CMPE-310/Lab4/Schematics/8086_Trainer_System/8086.JPG

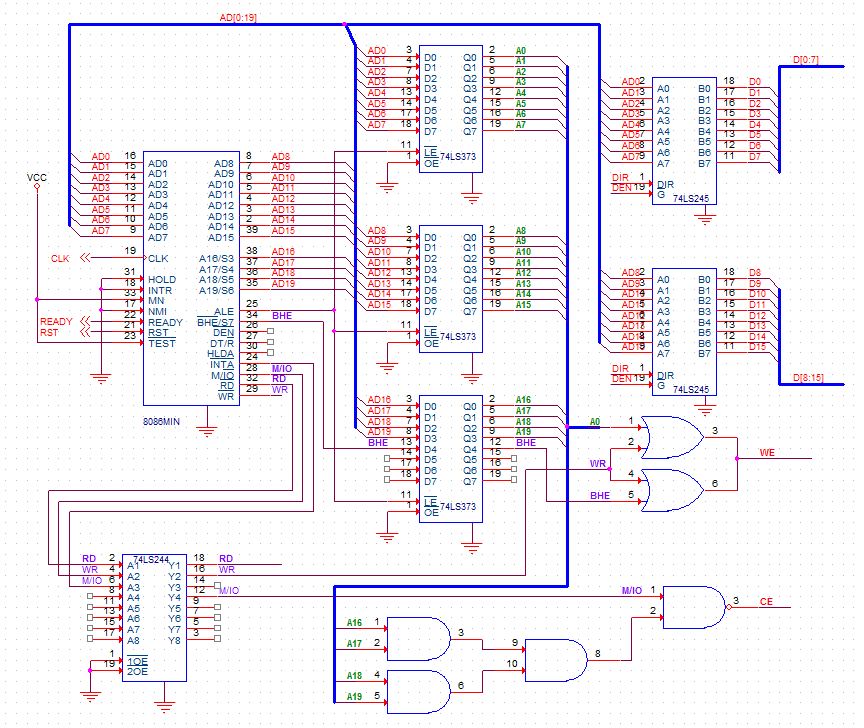
Schematics/8086_Trainer_System/8086.JPG
