CMPE-310/Lab4/Schematics/8086_Trainer_System/CY7C128A_SRAM_v2.JPG

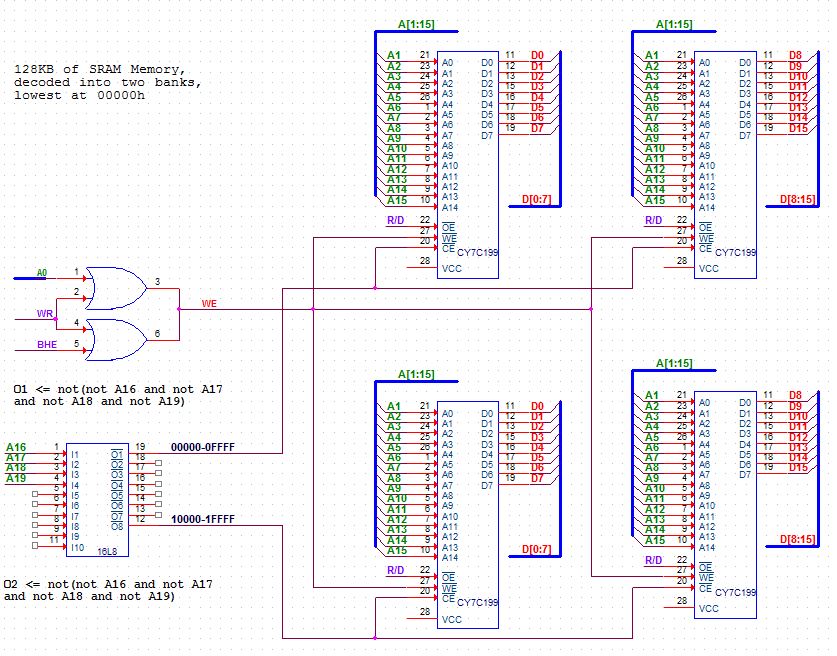
Schematics/8086_Trainer_System/CY7C128A_SRAM_v2.JPG
