CMPE-310/Lab4/Meeting #1 Notes.jpg

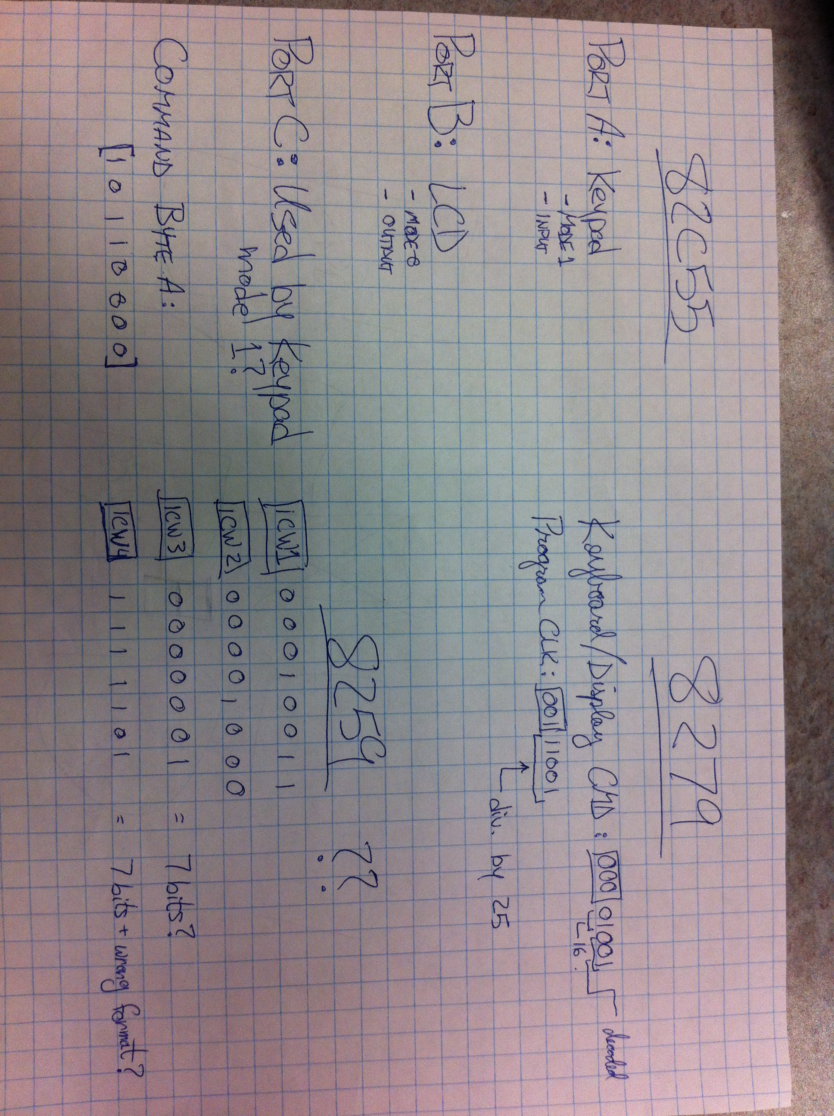
Meeting #1 Notes.jpg
