CMPE-310/Lab4/Program_8279_Microprocessor Techniques  By D.A.Godse A.P.Godse.tiff

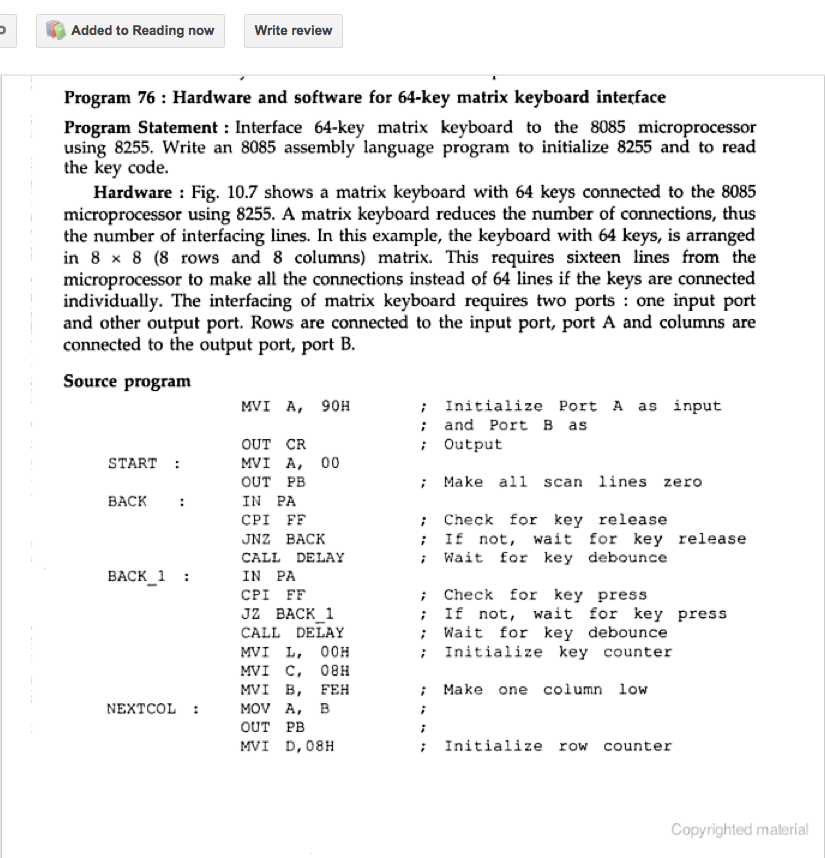
Program_8279_Microprocessor Techniques By D.A.Godse A.P.Godse.tiff
