CMPE-310/Lab4/Schematics/8086_Trainer_System/7 segement.PNG

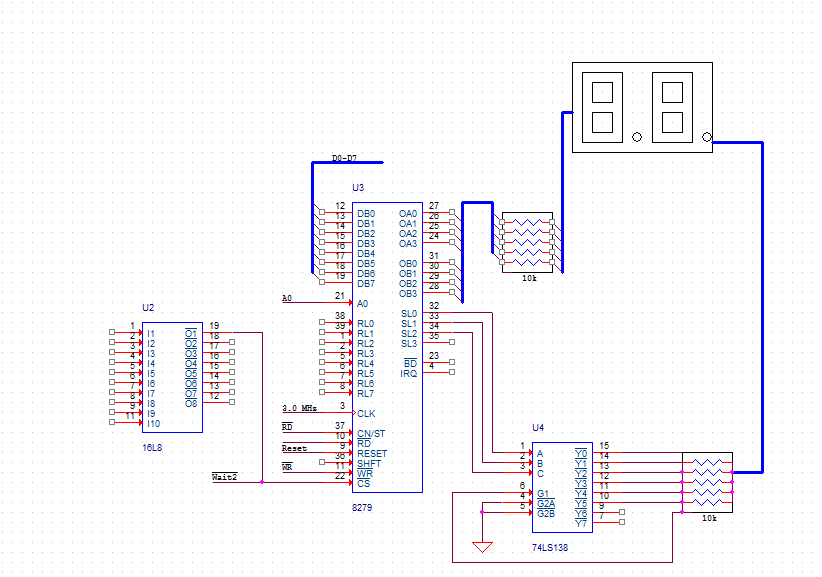
Schematics/8086_Trainer_System/7 segement.PNG
