CMPE-310/Lab4/Schematics/8086_Trainer_System/8 DIP SWITCHES CONNECTED TO A 74244.JPG

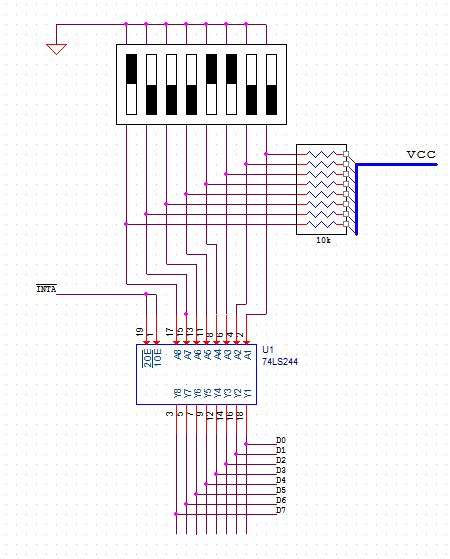
Schematics/8086_Trainer_System/8 DIP SWITCHES CONNECTED TO A 74244.JPG
