CMPE-310/Lab4/Schematics/8086_Trainer_System/LCD.PNG

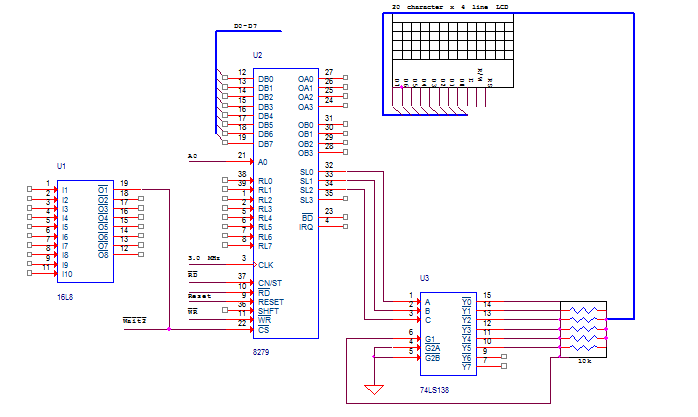
Schematics/8086_Trainer_System/LCD.PNG
