CMPE-310/Lab4/(list of files, drawings)

Other design files:
Schematics/8259.opj
Schematics/OrCAD_proj_files/2 COMMON-ANODE 7-SEG LEDS.DSN
Schematics/OrCAD_proj_files/2 common-anode 7-seg LEDs.opj
Schematics/OrCAD_proj_files/8 DIP SWITCHES CONNECTED TO A 74244.DSN
Schematics/OrCAD_proj_files/8 DIP switches connected to a 74244.opj
Schematics/OrCAD_proj_files/8086_OURS.DSN
Schematics/OrCAD_proj_files/8086_Ours.opj
Schematics/OrCAD_proj_files/8086_UMBC.DSN
Schematics/OrCAD_proj_files/8086_UMBC.opj
Schematics/OrCAD_proj_files/8254.DSN
Schematics/OrCAD_proj_files/8254.opj
Schematics/OrCAD_proj_files/8255_AND_KEYPAD.DSN
Schematics/OrCAD_proj_files/8255_and_keypad.opj
Schematics/OrCAD_proj_files/8259.DSN
Schematics/OrCAD_proj_files/8259.opj
Schematics/OrCAD_proj_files/8279_AND_KEYPAD.DSN
Schematics/OrCAD_proj_files/8279_and_Keypad.opj
Schematics/OrCAD_proj_files/16550.DSN
Schematics/OrCAD_proj_files/16550.opj
Schematics/OrCAD_proj_files/A POWER TERMINAL BLOCK.DSN
Schematics/OrCAD_proj_files/A power terminal block.opj
Schematics/OrCAD_proj_files/LCD.DSN
Schematics/OrCAD_proj_files/LCD.opj
Schematics/OrCAD_proj_files/Our Board LCD.opj
Schematics/OrCAD_proj_files/SRAM_OUR.DSN
Schematics/OrCAD_proj_files/SRAM_our.opj
