CMPE-310/Lab4/(commit log)

2013-12-07 More Versions
    - Added v3 program, will include Interrupts.
    - Added v4 program, will include Functionality.
    - Added v5 program, will include UI (final version of program).
2013-12-08 Schematics 01-03
    Schematic #03 might need to be slightly altered, but for the most part
    these jpegs are okay. I won't add them into the report till all are
    done. The numbering convention follows the list that is in the lab4
    assignment except they didn't number the list, I am numbering from top
    to bottom starting at zero, so we should be able to see clearly what is
    done and not done.
2013-12-08 renamed schematic files
    I got rid of the numbering convention, because I won't be able to keep
    trap. If there is something you are looking for, the file name itself
    should be enough.
2013-12-08 lab4 report
    outline is colored. since git can track changes I'm not sure if you guys
    want to write in your own colors or not. Please try to work on the
    report everyday.
2013-12-08 Products of a sample cross compilation
    Used the sample provided to make sure cross-compilation with dosbox was
    a success
2013-12-09 added problem description 2 & some schematics
2013-12-09 schematics for clock gen
2013-12-09 Bruce ver1
    This is what I have so far. I decided it would be nice to have a flow
    chart of the program for our benefit and so we could also possibly put
    it in the report. I don't know where it would go but most likely it
    would be in the software section. I am still working on the report but
    before I continue I would like to meet to discuss some of these
    sections.
2013-12-09 (Bruce) - added test plan & flowchart
2013-12-09 (Bruce) - added SRAM & some I/O
    Everyone note that I added 7-Segment Display and LEDs to Outline in the
    I/O section so that will also need to be written. Thanks, Nat
2013-12-10 Logic Flow Chart.
    I changed the original flow chart and added a new one so when it is time
    to program it we will know all the equations.(though multiply decimals
    really means multiply by a whole number then dividing by a whole number
    in assembly.
2013-12-11 added two schematics & updated the report
    also added the OrCad project files for these 2 schematics only
    [8255_AND_KEYPAD.DSN, 8255_and_keypad.opj, 8279_AND_KEYPAD.DSN, 8279_and_Keypad.opj]
2013-12-11 ASM v3.1
    - Added interrupt vector table.
    - Added skeleton for INTR1 routine.
2013-12-14 16550 - Took me 2 hours to do this one!
    [16550.DSN, 16550.opj]
2013-12-14 more 16550
    [16550.opj]
2013-12-14 more 8255
    [8255_and_keypad.opj]
2013-12-14 LCD Display
    other schematics coming later this night.
    [LCD.opj]
2013-12-14 Revert "LCD Display"
    This reverts commit 1175a6bb8666c44cfbd5228bd6dd4121099c9a96.
    [LCD.opj]
2013-12-14 updated report with new schematics so far
2013-12-14 LCD Display
    Half way done on other one.
    [LCD.opj]
2013-12-14 LCD and 7 segement display
    [2 common-anode 7-seg LEDs.opj, 8 DIP switches connected to a 74244.opj, LCD.opj]
2013-12-14 8 Dip Switches
    [2 COMMON-ANODE 7-SEG LEDS.DSN, 8 DIP SWITCHES CONNECTED TO A 74244.DSN, LCD.DSN]
2013-12-14 8 dip switch picture
2013-12-14 Power block, updated switch
    [8 DIP SWITCHES CONNECTED TO A 74244.DSN, A POWER TERMINAL BLOCK.DSN, A power terminal block.opj]
2013-12-15 ASM v3.0
    - Added interrupt vector creation.
    - Added key reading.
    - Added raw-to-ASCII conversion.
2013-12-15 Our LCD, 2 Common -Anode 7-SEG LEDS, Power Block, 8 DIP Switches
    [Our Board LCD.opj]
2013-12-17 ASM v3.1 - WORKING BUILD
    - Numerous changes.
    - Program now handles interrupts correctly.
    - Program reads correct input values.
2013-12-17 added bruce's schematics & I completed my writing
2013-12-17 ALL SCHEMATICS ARE DONE AND INCLUDED IN REPORT!
    PS, I'm also done writing!!!
    [8086_OURS.DSN, 8086_Ours.opj, 8086_UMBC.DSN, 8086_UMBC.opj, SRAM_OUR.DSN, SRAM_our.opj]
2013-12-18 final report that i'm printing and submitting now
